hongstex/warehouse-dev/docs/方案说明_v1.md

# 5 楼面料仓货架布置 v1

网页：`public/index.html`（方案切换、2D 平面、3D 立体、用料表）。
图纸：`public/files/layout_5F_{A,B}_v1.{png,pdf,dxf}`。DXF 单位 mm，原点为 3-1×3-A 轴交点，每格标注仓位编码。
生成：`python3 layout/generate.py`，所有参数在脚本顶部。

## 已确认条件
| 项目 | 内容 |
|---|---|
| 楼层 | 5 层，层高 4.3m，柱网 8m×8m，96m×24m。东端 3-11~3-13 南墙为 JM2 门 |
| 7 楼做法 | 东西向通长货架沿主通道布置，隔一段空一格做过道 |
| 取放 | 人工爬梯，5 楼另加辅助小叉车 |
| 布卷 | 直径 35~40cm，每卷 20~30kg，幅宽 140~180 |
| 货梯 | 约 40 卷一趟 |
| 功能区 | 不吊装。办公室放东南角，验布/分拣放在东货梯收发区和 JM2 门附近 |
| 管理 | 按品种管理，不要求先进先出，周转不高 |
| 高度 | 3.8~4m 可用，二层布匹一般不堆到顶 |
| 楼面荷载 | 足够（7 楼同样使用） |

## 方案对比（以南北向方案 A 为主展示）
| | 方案 A 南北向短排 | 方案 B 东西向通长 |
|---|---|---|
| 仓位（格×2 层） | 384 | 388 |
| 可存布卷 | 6,144~9,600 | 6,208~9,700 |
| 作业通道 / 主通道 | 2.0m（柱位处 1.7m）/ 3.0m | 2.3m / 2.65m |
| 小叉车 | 基本只能走主通道 | 可进作业通道（低速） |
| 货架段数 | 70 | 38 |
| 钢材净重（主材 50×50×2.5） | 约 30.1t | 约 27.7t |
| 与 7 楼一致 | 否 | 是 |

下面「方案 B 断面」供参考，其余用料、构造以方案 A 为准。

### 方案 B 断面（自南向北）
南墙单排 1.95 → 通道 2.3 → 双排 4.0（含 3-B 轴柱）→ 通道 2.3 → 单排 1.95（两面可取）→ 主通道 2.65 → 双排 4.0（含 3-C 轴柱）→ 通道 2.3 → 北墙单排 1.95。合计 23.4m。

- 3-B、3-C 轴的柱子落在双排里，每 8m 柱距放 3 格，柱位那一格空着，不占通道。
- 横向过道共 4 处，都是空出一格宽：西端、东端各一处，3-4 和 3-10 轴附近各一处（避开消火栓）。另外，3-7 轴卷帘带同时作为过道。

## 每格容量与荷载
- 单格：沿排方向 2.0m（净 1.92m）× 进深 1.95m × 2 层。
- 一层承货面标高 0.15m，二层 2.0m，立柱高 3.8m。
- 每格每层可放：
  - 40cm 布卷：4×4 = 16 卷；
  - 35cm 布卷：5×5 = 25 卷，但二层梁需上调到约 2.1m，货顶约 3.9m。
- 荷载：每格最多约 1.5t，货架投影下约 3.8 kN/m²，全层平均约 1 kN/m²。

## 货架构造（螺栓连接，不烧焊）
- **立柱：** 50×50×2.5（已确认；网页下拉可切换 40×40、60×60、80×80 对比），正面和侧面按 50mm 间距冲 φ11 孔，层高可调。
- **侧片：** 每列前后两根立柱，用三道横撑（一层、二层、柱顶，50×50×2.5）加两道斜撑（40×40×2）组成。
- **承货：**
  - 每层前后各一根承货梁（50×50×2.5），加两根中间托梁（60×40×2）。
  - 布卷卷轴朝进深方向，140 幅宽的布卷也至少搭在两根梁上。
- **连接：**
  - 梁端用 L50×50×5 冲孔角码（长 80，两颗螺栓按 50mm 孔距），配 M10×80 螺栓 4 套。
  - 方管内建议加套管，防止拧紧时压扁管壁。
- **稳定：**
  - 背面每 4 格设一道剪刀撑。
  - 背靠背两排在中部和顶部用短管拉结。
- **地脚：** 底板 120×120×6，每柱 2 个 M12 机械锚栓。打孔深度要控制，并避开楼板内管线。

## 用料（方案 A，主材 50×50×2.5）
| 部件 | 数量 |
|---|---|
| 立柱 50×50×2.5 L=3800 | 524 |
| 承货梁 50×50×2.5 L=1950 | 768 |
| 横撑 50×50×2.5 L=1850 | 786 |
| 中间托梁 60×40×2 L=1950 | 768 |
| 侧片斜撑 40×40×2 L=2724 | 524 |
| 背面剪刀撑 40×40×2 | 184 |
| 背靠背拉杆 40×40×2 L=300 | 252 |
| 底座（120×120×6 底板 + L50 角码） | 524 套 |
| M12 锚栓 | 1,048 套 |
| 梁端角码 L50×50×5 L=80 | 3,108 个 |
| 托梁卡件 | 1,536 个 |
| M10×80 螺栓 | 13,984 套 |
| Φ16×2.5 防压套管 L=50 | 13,984 个 |
| M8 螺栓 | 1,416 套 |

- **6m 定尺采购：** 50×50×2.5 共 868 根，40×40×2 共 354 根，60×40×2 共 256 根。
- **复核点：** 承货梁每格每层最多约 750kg，估算 50×50×2.5 单根挠度约 L/400，可接受；立柱 3.8m 的稳定性、M10 螺栓处加套管、L50 角码节点承载仍需结构复核。
- **五金核算（按 50×50）：** 底板由 150×150×8 减到 120×120×6；角码 L50 宽度正好等于管宽，长度取 80 才放得下两颗 M10（50mm 孔距、边距 15mm），所以每端仍是 4 颗螺栓；螺栓由 M10×100 缩为 M10×80；每个过管螺栓加 1 个套管。锚栓（每柱 2 个 M12）、卡件、M8 斜撑螺栓数量不变。
- **单价：** 网页上可直接修改单价，合计会自动重算。

## 风险 / 需复核
1. **螺栓货架稳定性：** 先做一段样架，试装、试载。
2. **叉车（型号待定）：** 方案 A 作业通道 2.0m（柱位处 1.7m），小叉车基本只走 3.0m 主通道；若要进作业通道，车身最好不超过约 1.1m 且需低速。
3. **货顶净空：** 二层一般不堆满到顶；安装时注意货顶与喷淋头之间留出净距。
4. **消防：** 丙类厂房改作仓储可能涉及使用功能变更；卷帘下方和疏散通道不得堆货。
5. **读图估计项：** 核心筒、门位、消火栓位置需现场复核。

## 待定
- 小叉车型号。
- 办公室、验布区面积（图中暂按约 38m² / 57m²）。
