hongstex/warehouse-dev/public/files/layout_5F_A_v1.png

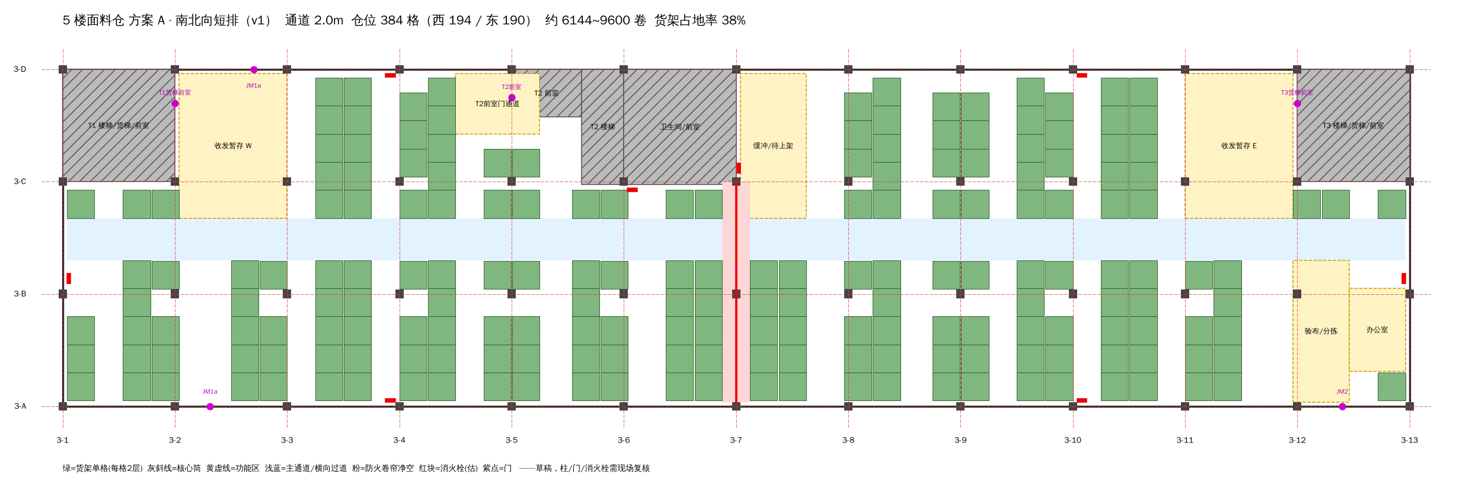
public/files/layout_5F_A_v1.png
