hongstex/warehouse-dev/public/files/layout_5F_B_v1.png

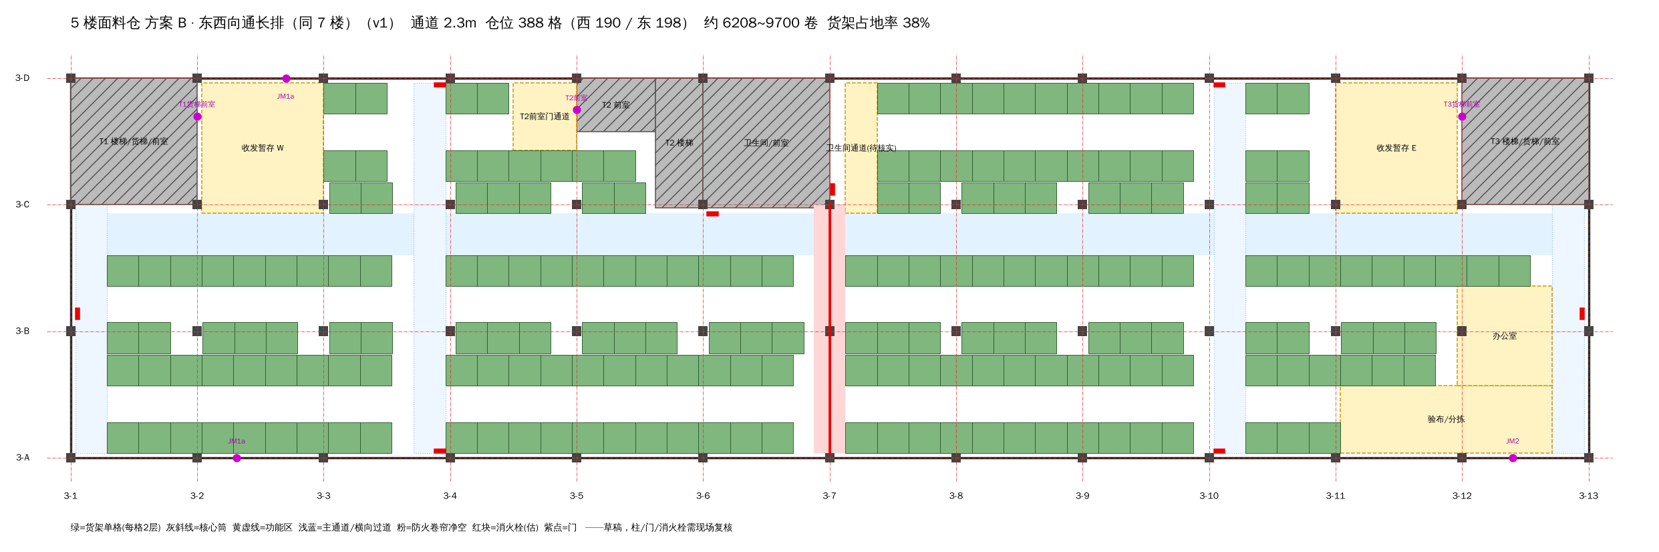
public/files/layout_5F_B_v1.png
