hongstex/warehouse-dev/public/files/layout_v0.dxf

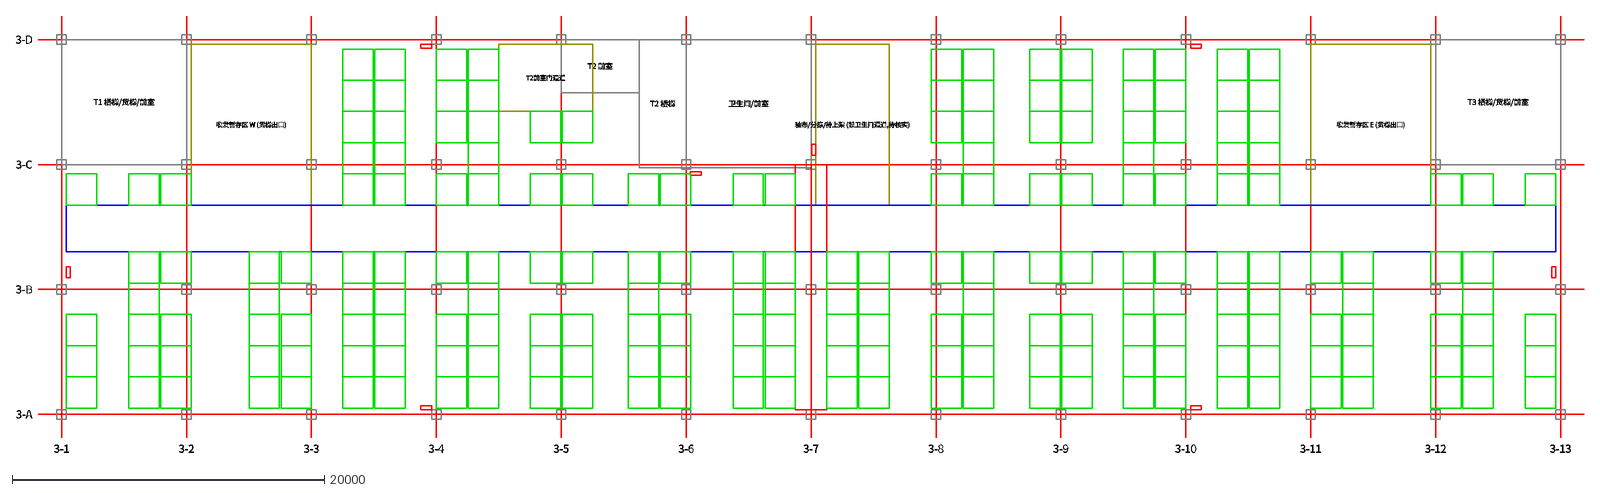
[picture p3: CAD file, 2026-10-11]
public/files/layout_v0.dxf
3-1
3-2
3-3
3-4
3-5
3-6
3-7
3-8
3-9
3-10
3-11
3-12
3-13
3-A
3-B
3-C
3-D
T1 楼梯/货梯/前室
T2 前室
T2 楼梯
卫生间/前室
T3 楼梯/货梯/前室
收发暂存区 W (货梯出口)
收发暂存区 E (货梯出口)
验布/分拣/待上架 (兼卫生间通道,待核实)
T2前室门通道
