hongstex/warehouse-dev/(list of files, cad)

Other CAD files:
public/files/layout_5F_A_v1.dxf
public/files/layout_5F_B_v1.dxf
