hongstex/warehouse-dev/public/files/layout_5F_A_v1.pdf

## 5 楼面料仓 方案 A · 南北向短排（v1） 通道 2.0m 仓位 384 格（西 194 / 东 190） 约 6144~9600 卷 货架占地率 38%

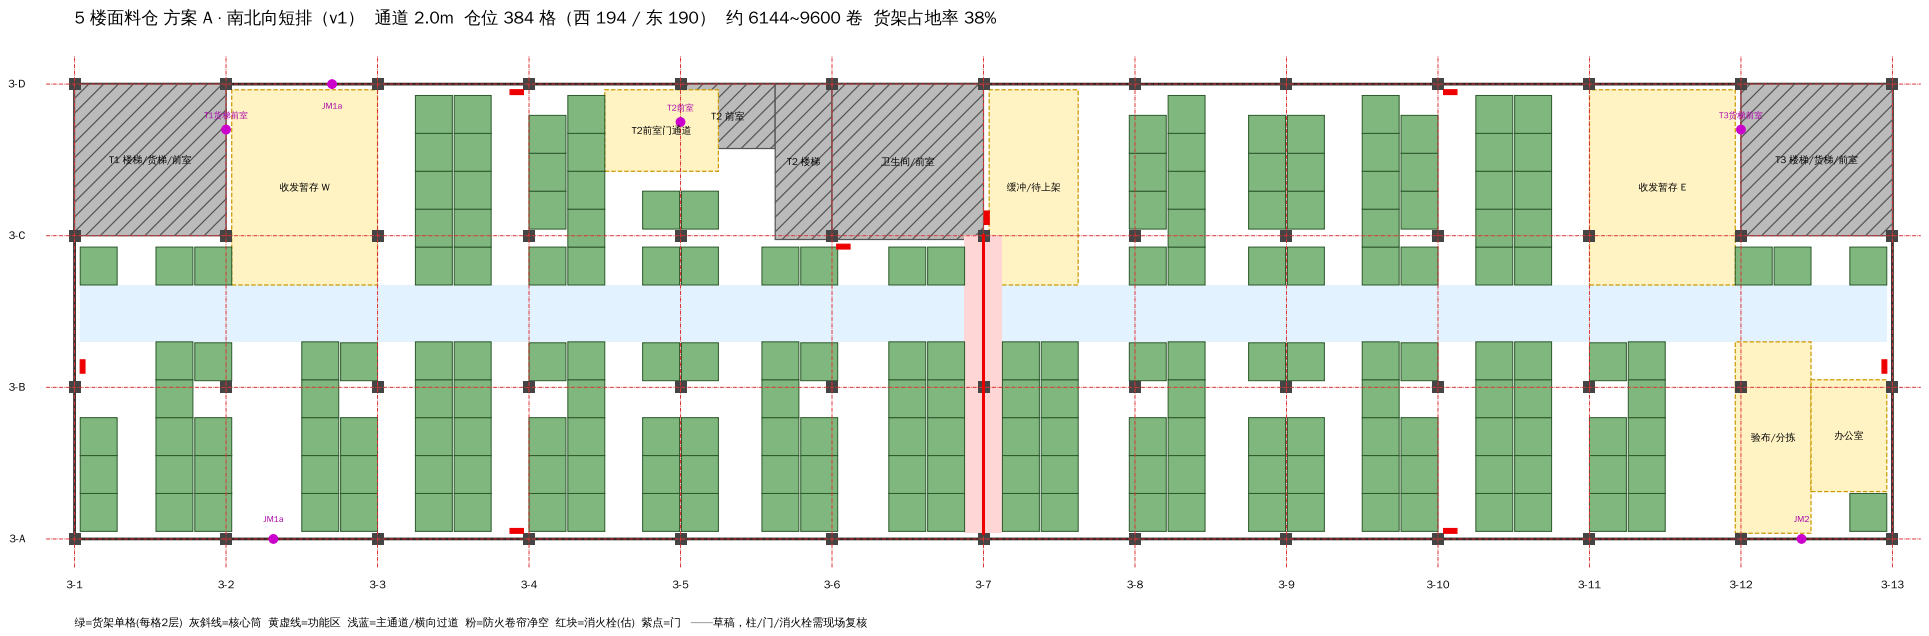
[picture p4: page 1]
卫生间/前室; 收发暂存 W; 收发暂存 E; 办公室; 缓冲/待上架; T2前室门通道; T1货梯前室; T3货梯前室

绿=货架单格(每格2层) 灰斜线=核心筒 黄虚线=功能区 浅蓝=主通道/横向过道 粉=防火卷帘净空 红块=消火栓(估) 紫点=门 ——草稿，柱/门/消火栓需现场复核
