hongstex/warehouse-dev/public/files/layout_5F_B_v1.pdf

# 5 楼面料仓 方案 B · 东西向通长排（同 7 楼）（v1） 通道 2.3m 仓位 388 格（西 190 / 东 198） 约 6208~9700 卷 货架占地率 38%

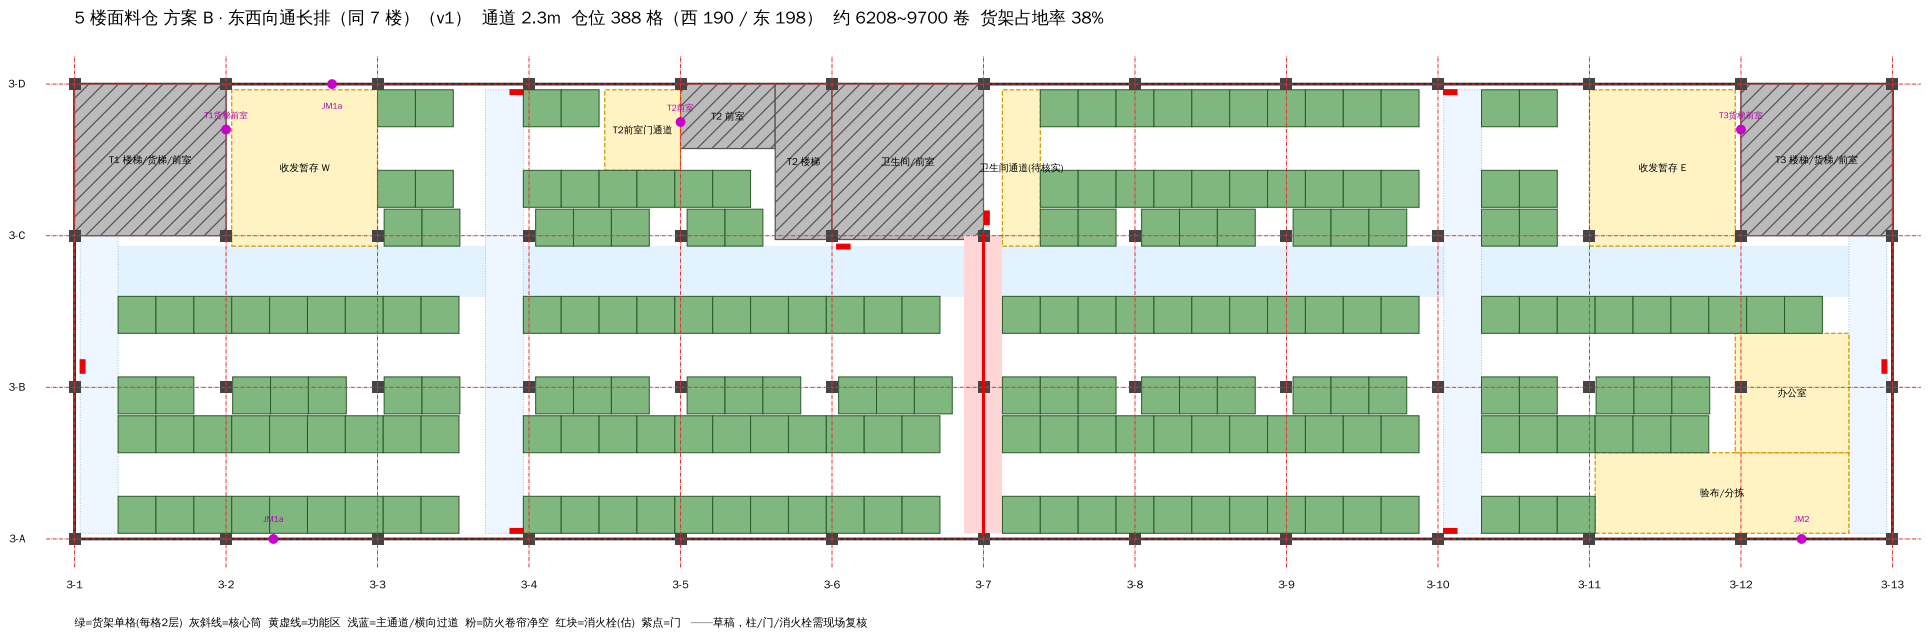
[picture p5: page 1]
卫生间/前室; 收发暂存 W; 收发暂存 E; 办公室; T2前室门通道; 卫生间通道(待核实); T1货梯前室; T3货梯前室

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
