hongstex/warehouse-dev/(commit log)

2026-10-11 Add fabric warehouse rack layout draft v0 (plan, DXF, generator)
    Claude-Session: https://claude.ai/code/session_01YJycx5ix3YheAuiwe3PtDB
    [layout_v0.dxf]
2026-10-11 Turn project into a Cloudflare Pages static site
    Generator now writes data and downloads into public/; add interactive
    plan page, Pages config (wrangler.toml, _headers) and deploy notes.
    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
    [layout_v0.dxf]
2026-10-11 Add 5F schemes A/B, 3D view and bolted-rack BOM
    - Generator now lays out two schemes: A (N-S short rows, 2.0m aisles) and
    B (E-W continuous rows as on 7F, 2.3m aisles for a small forklift)
    - Zones updated for 5F: office SE, inspection by east lift and JM2 door
    - Per-run rack frames feed a bolted (no welding) material list with 6m
    stock cutting; capacity from 35-40cm roll diameter
    - Page: scheme switch, 2D plan, three.js 3D view, editable unit prices
    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
    [layout_5F_A_v1.dxf, layout_5F_B_v1.dxf]
2026-10-14 Switch main tube to 40x40x2 and add section dropdown options
    Main members (post/beam/cross) default to 40x40x2; dropdowns offer 40x40
    wall thicknesses, 50/60/80 square tubes. Member lengths follow post width.
    Claude-Session: https://claude.ai/code/session_01TA1YBpwVZ2zZixiUjjSB8V
2026-10-14 Use 40x40x2.5 main tube, L50 angle brackets, make scheme A primary
    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
2026-10-14 Use 50x50x2.5 as main tube
    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
2026-10-14 Recheck hardware for 50x50: smaller base plate, L50x80 angle, M10x80 bolts, add sleeves
    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
2026-10-24 Add interactive rack editor: drag-and-drop floor plan and 3D block-style frame builder
    Plan tab: move/rotate/copy rack runs with edge and aisle snapping, live clearance
    dims, conflict checks (columns, cores, hydrants, shutter band, zones), zones,
    notes and measurements. Frame tab: click to place posts, beams, braces, decks
    and rolls on an editable grid with a live BOM. Both export one JSON for review.
2026-10-26 Editor: multiple named designs saved in browser (new / copy / rename / delete / switch)
    Import now creates a new design instead of overwriting; export includes the design name.
2026-10-26 Editor: cloud sync of designs via Pages Function + D1
    Devices sharing a sync code see the same designs; per-design last-writer-wins,
    deletes propagate as tombstones. Sync link (#sync=code) joins a device in one tap.
2026-10-28 Frame editor: place posts anywhere by tapping the floor
    New x/z grid lines are inserted automatically; beams, braces and decks spanning
    the split bay are divided in two. Snaps to existing lines within 150mm, else to the grid step.
2026-10-28 Frame BOM: show metres per member, total metres and per-section metre subtotals
2026-10-28 Frame editor: label depth-direction add/remove as 一列 and explain grid buttons
2026-10-28 Link plan and 3D: whole-warehouse 3D view built from the unit, warehouse BOM, apply unit size to racks
    - 3D tab gets 单元 / 全仓 toggle; 全仓 tiles the unit's bays along every plan rack
    (instanced meshes, oriented by rack axis + pick face, scaled to rack cell/depth)
    - Frame panel shows whole-warehouse BOM (count, metres, kg, per-section metres)
    - Plan panel: unit summary, mismatch count, 货架尺寸按 3D 单元, 看全仓 3D
    - Export summary includes warehouse BOM and unit spec
2026-10-28 Multiple rack units: each plan rack picks its unit
    - State holds units [{id,name,frame}] + unitCur; S.frame is a non-serialised accessor to the
    current unit (or a withFrame override), so existing frame code is unchanged
    - Old single-frame saves migrate to one unit
    - 3D panel: unit picker with new / copy / rename / delete (racks reassigned on delete)
    - Plan: per-rack 结构单元 field, unit name on racks, unit summary per unit
    - Whole-warehouse 3D and BOM combine all units; export summary lists each unit
